Losasos/CP_PP_Tester/README.md

# CP_PP_Tester
Tester equipment for simulation of PWM communication (IEC61851-1) between electrical vehicle (EV) and a charging station (EVSE)
