Losasos/CP_PP_Tester/relay states.xlsx

# | Designator | Quantity | Part Number | Comment | Description | Manufacturer
1 | Rc5 | 1 |  | 51R
2 | Rc4 | 1 |  | 100R
3 | R13 | 1 |  | 120R
4 | R51 | 1 |  | 130R
5 | R52 | 1 |  | 140R
6 | R6 | 1 |  | 150R
7 | R50 | 1 |  | 178R
8 | R11, Rc3 | 2 |  | 220R
9 | R4, R7 | 2 |  | 330R
10 | R41 | 1 |  | 392R
11 | R40 | 1 |  | 422R
12 | R10, Rc2 | 2 |  | 680R
13 | R42 | 1 |  | 909R
14 | R31 | 1 |  | 920R | 910 +10
15 | R12 | 1 |  | 1000R
16 | Rc1 | 1 |  | 1500R
17 | R32 | 1 |  | 1820R | 1800 + 20
18 | R30 | 1 |  | 1870R
19 | R5 | 1 |  | 2700R
20 | R3 | 1 |  | 100k
21 | Rf1, Rf2 | 2 |  | 1M
22 | Cg | 1 |  | 1nF
23 | Cv | 1 |  | 1.4nF | 1,5nF
24 | Cc | 1 |  | 1.5nF
25 | Cf1, Cf2 | 2 |  | 47nF
26 | L1 | 1 |  | 1mH
27 | D1 | 1 | 1N4934 |  | Rectifier diode
28 | HF-Gen, Oszi | 2 |  |  | BNC connector
29 | SW_M | 1 |  |  | 2 state switch with 4 outputs, 1 or 2 inputs
30 | MOD1, MOD2 | 2 |  |  | Relays module, 8x relays, 5V DC control | ELEGOO
31 | MOD3 | 1 |  |  | Relays module, 4x relays, 5V DC control | ELEGOO
32 | MOD4 | 1 | Arduino Genuino MEGA 2560 |  | Arduino Uno R3 module, ATmega2560 + ATmega16U2 MCU | Sunfounder
33 | MOD5 | 1 |  |  | LCD display module, 16x2 characters, HD44780, with I2C driver | AZ Delivery
34 | MOD6 | 1 |  | 10k max | Digital potentiometer module, X9C103S IC, [P1] | ARCELI
35 | MOD7 | 1 |  |  | Keypad module 4x4 | AZ Delivery
36 | Ph, N, CP, Prox, PE, +V DC, h, RL-Ph, PL-N | 9 |  |  | Banana connector
37
38
39
40
41
42
43
44
45
46
47
48
49
