Losasos/CP_PP_Tester/TesterBox_top-Body.stl

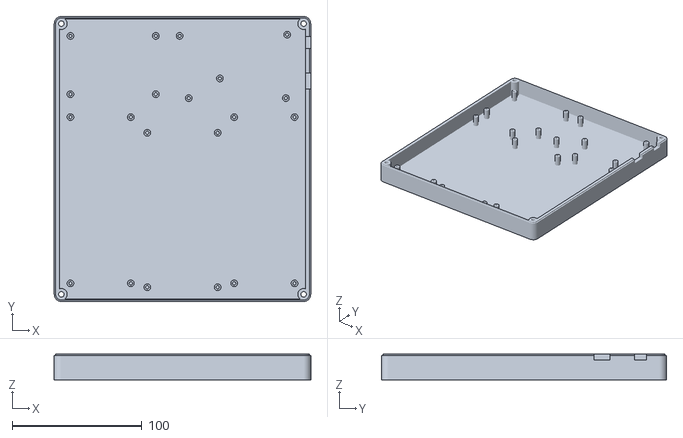
[picture p1: CAD file, 2026-03-22]
TesterBox_top-Body.stl
198.0 x 220.0 x 20.0
