Losasos/CP_PP_Tester/Tester_CP_PP.v2-cache.lib

## KiCad design Tester_CP_PP.v2-cache.lib (2026-03-22)

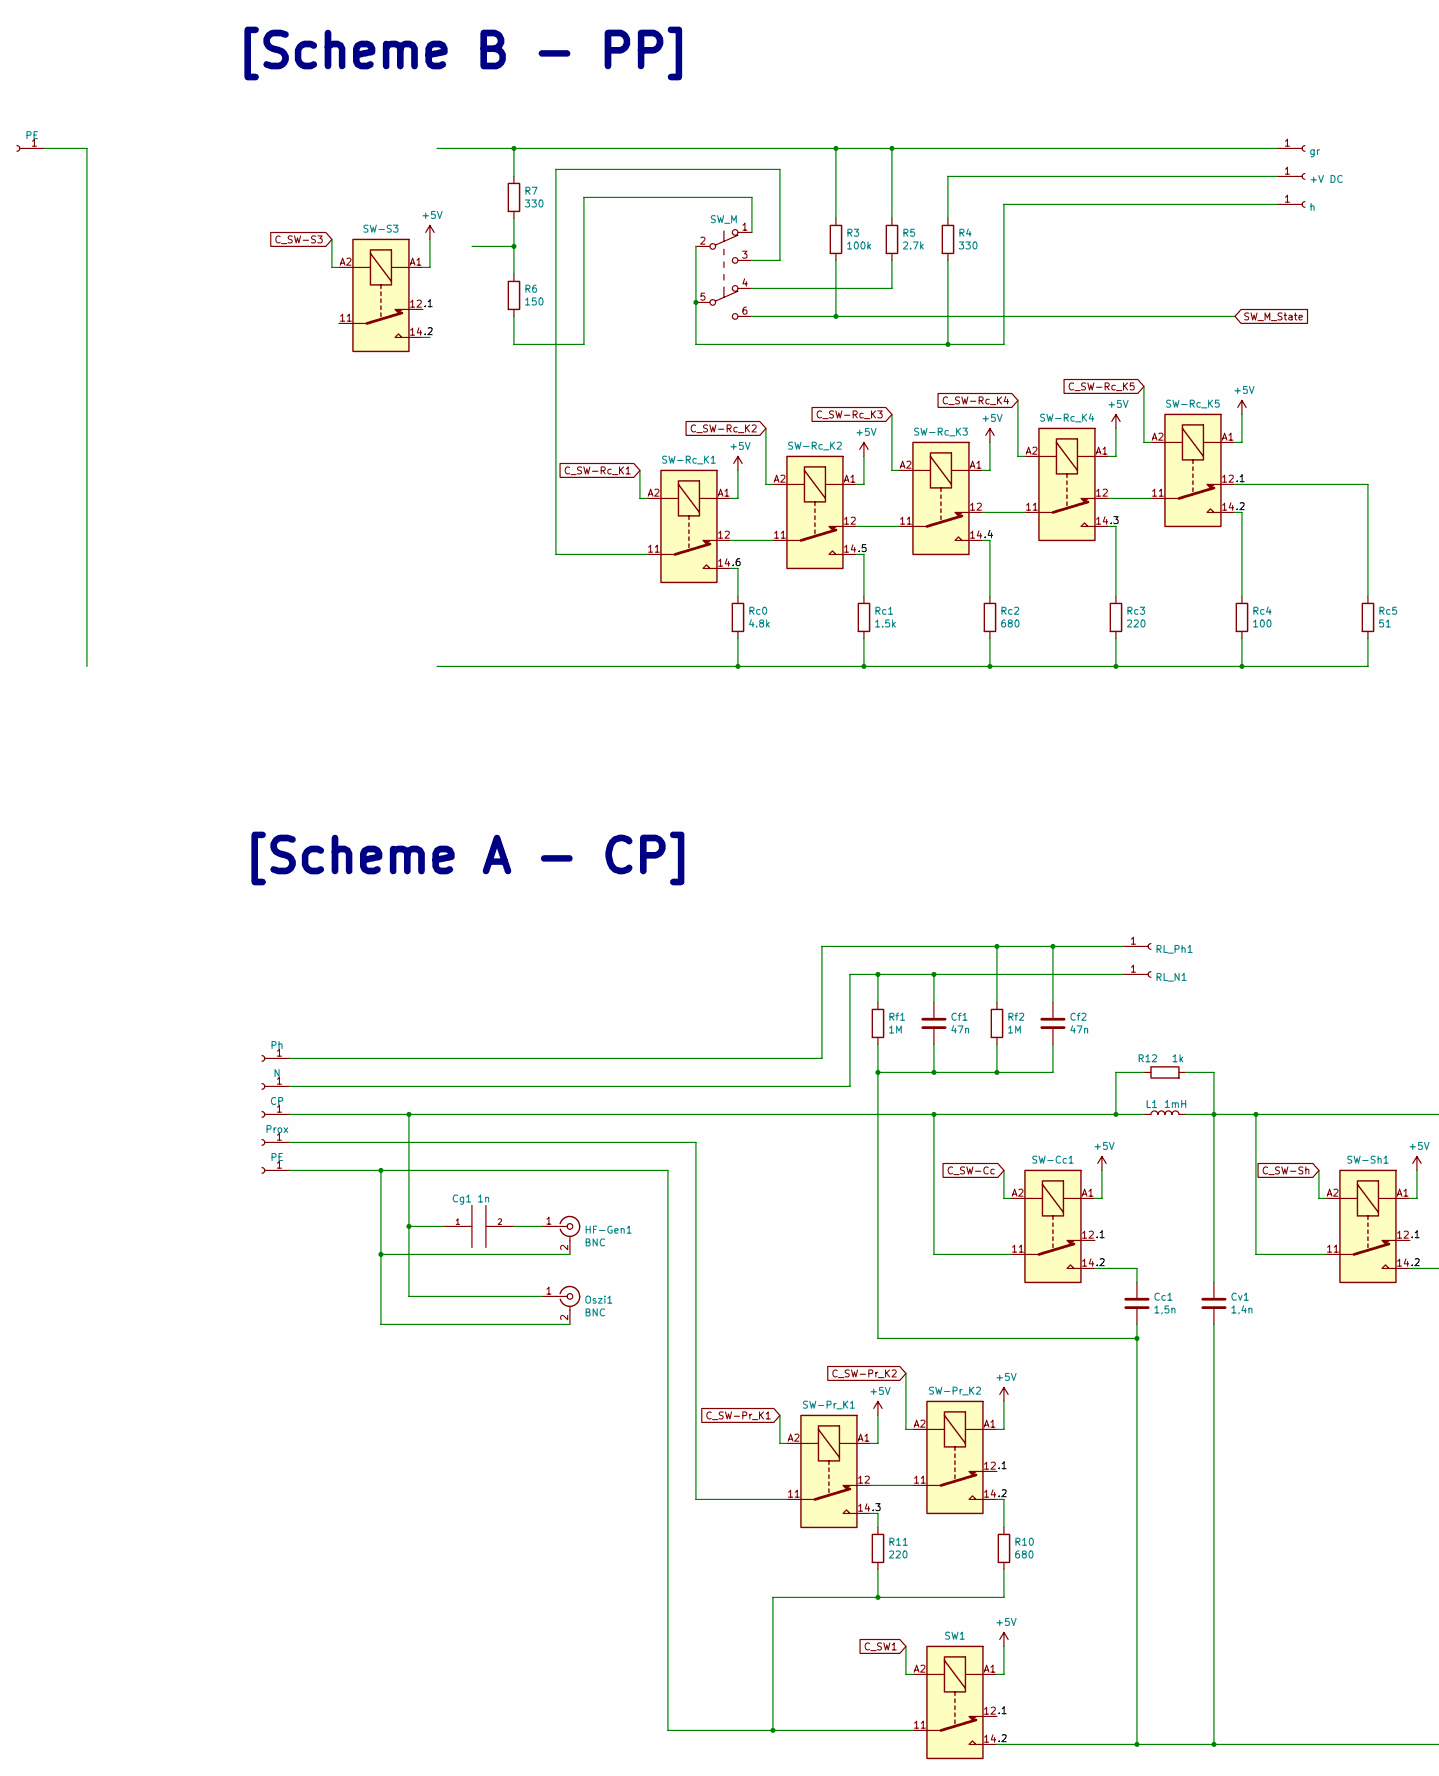
[picture p2: schematic Tester_CP_PP.v2-cache.lib, part in row 1, column 1]

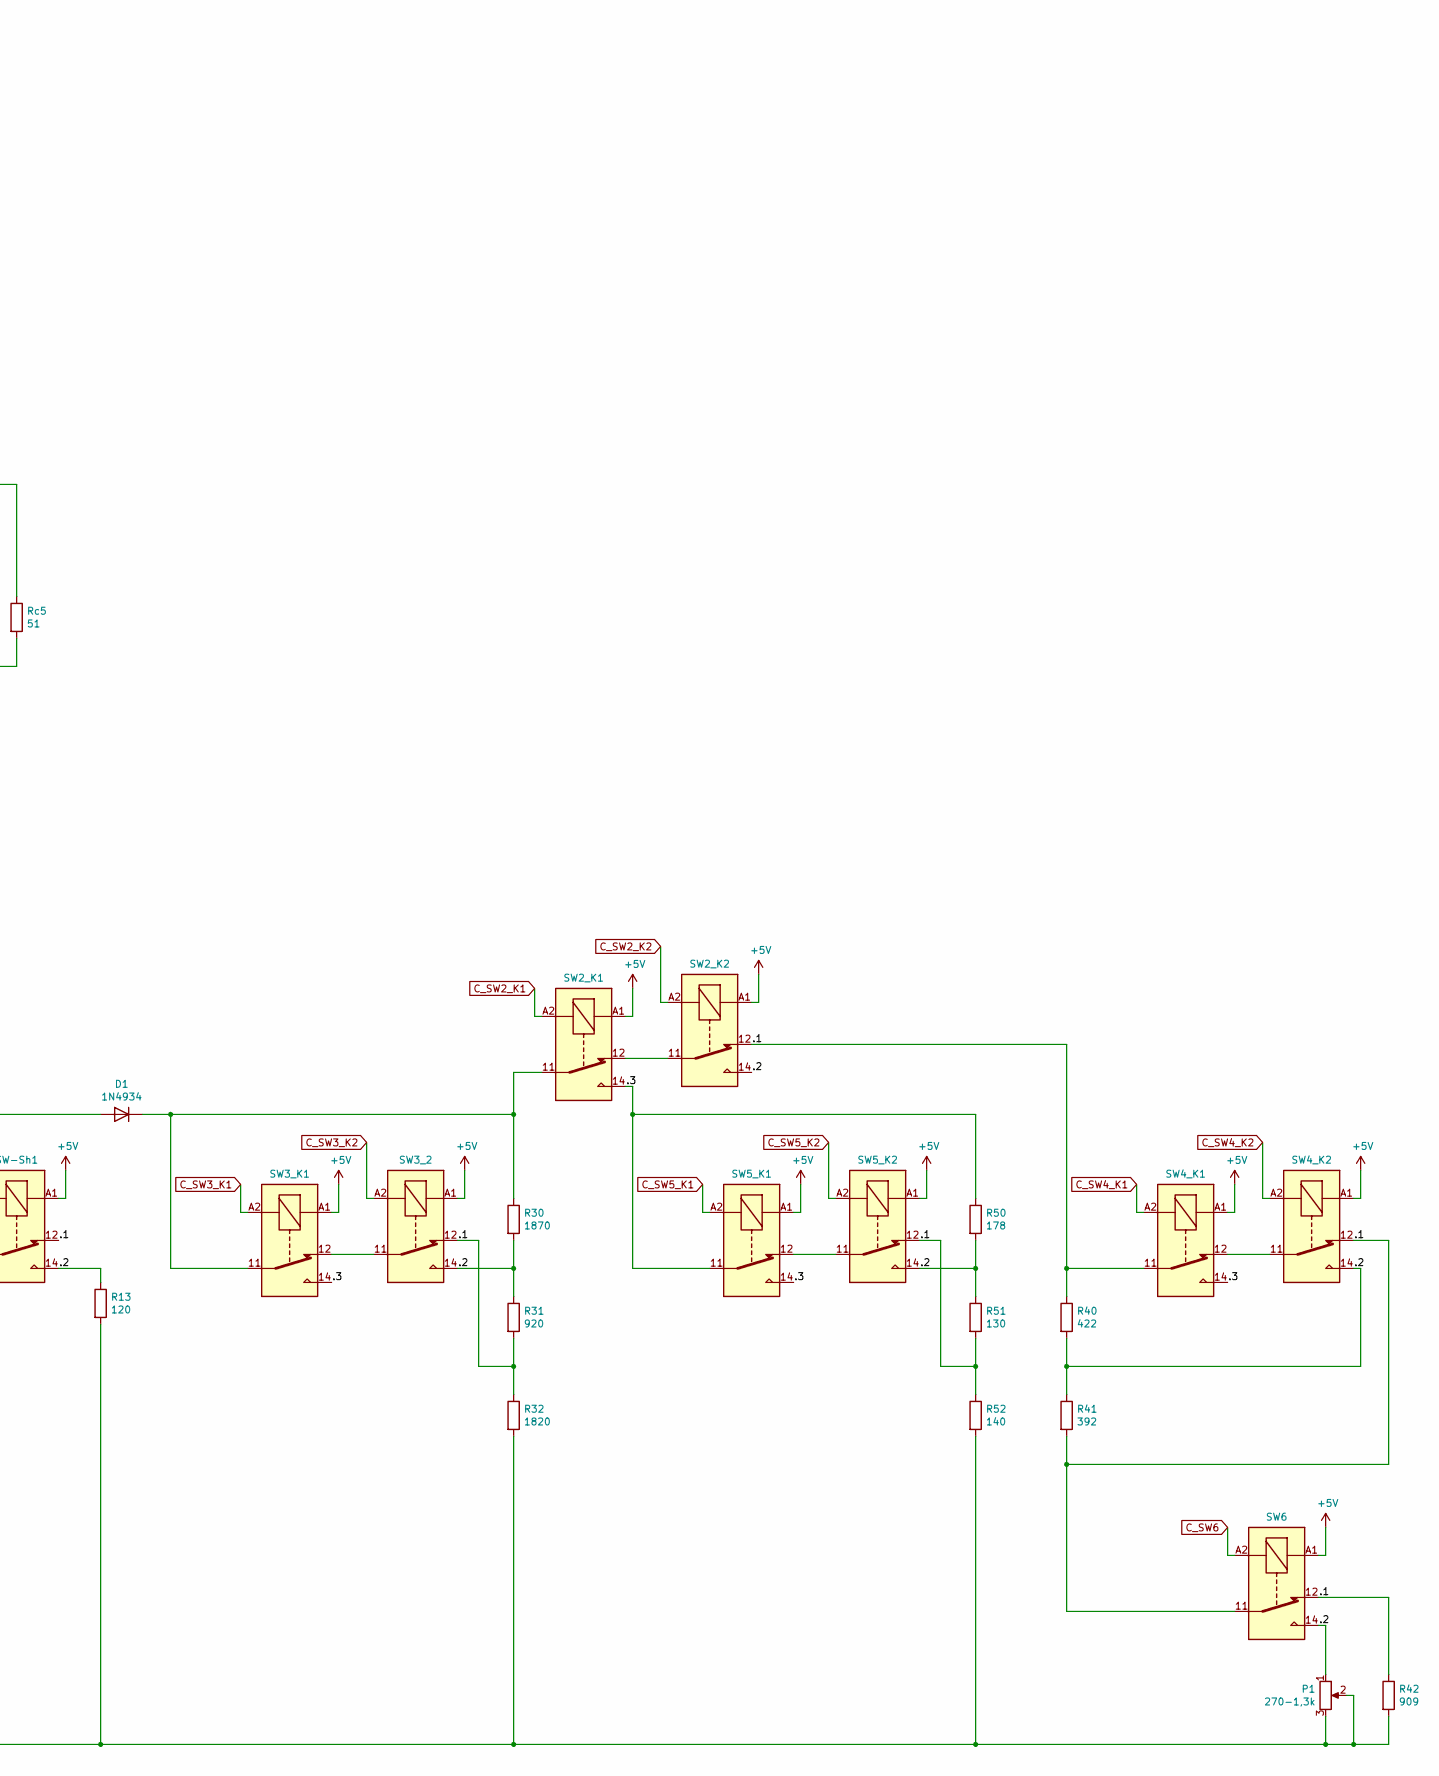
[picture p3: schematic Tester_CP_PP.v2-cache.lib, part in row 1, column 2]

Parts:
Banana1: PE
Banana2: gr
Banana3: +V DC
Banana4: h
Banana_socket1: Ph
Banana_socket2: N
Banana_socket3: CP
Banana_socket4: Prox
Banana_socket5: PE
Cc1: 1,5n
Cf1, Cf2: 47n
Cg1: 1n
Cv1: 1,4n
D1: 1N4934
HF-Gen1: BNC
L1: 1mH
Oszi1: BNC
P1: 270-1,3k
R3: 100k
R4, R7: 330
R5: 2.7k
R6: 150
R10: 680
R11: 220
R12: 1k
R13: 120
R30: 1870
R31: 920
R32: 1820
R40: 422
R41: 392
R42: 909
R50: 178
R51: 130
R52: 140
RL_N1: N
RL_Ph1: Ph
Rc0: 4.8k
Rc1: 1.5k
Rc2: 680
Rc3: 220
Rc4: 100
Rc5: 51
Rf1, Rf2: 1M
SW1, SW2_K1, SW2_K2, SW3_2, SW3_K1, SW4_K1, SW4_K2, SW5_K1, SW5_K2, SW6: .; Relay_SPDT_Finder_40.41
SW-Cc1: .; Relay_SPDT_Finder_40.41
SW-Pr_K1, SW-Pr_K2: .; Relay_SPDT_Finder_40.41
SW-Rc_K1, SW-Rc_K2, SW-Rc_K3, SW-Rc_K4, SW-Rc_K5: .; Relay_SPDT_Finder_40.41
SW-S3: .; Relay_SPDT_Finder_40.41
SW-Sh1: .; Relay_SPDT_Finder_40.41

Connections:
+5V: SW1.A1, SW2_K1.A1, SW2_K2.A1, SW3_2.A1, SW3_K1.A1, SW4_K1.A1, SW4_K2.A1, SW5_K1.A1, SW5_K2.A1, SW6.A1, SW-Cc1.A1, SW-Pr_K1.A1, SW-Pr_K2.A1, SW-Rc_K1.A1, SW-Rc_K2.A1, SW-Rc_K3.A1, SW-Rc_K4.A1, SW-Rc_K5.A1, SW-S3.A1, SW-Sh1.A1
.1: R31.2, R32.1, R40.1, R41.2, R42.1, R51.2, R52.1, Rc5.1, SW1.12, SW2_K2.12, SW3_2.12, SW4_K1.11, SW4_K2.12, SW5_K2.12, SW6.11, SW6.12, SW-Cc1.12, SW-Pr_K2.12, SW-Rc_K5.12, SW-S3.12, SW-Sh1.12
.2: Cc1.1, Cc1.2, Cf1.2, Cf2.2, Cv1.2, P1.1, P1.2, P1.3, R10.1, R13.1, R13.2, R30.2, R31.1, R32.2, R40.2, R41.1, R42.2, R50.2, R51.1, R52.2, Rc4.1, Rf1.2, Rf2.2, SW1.14, SW2_K2.14, SW3_2.14, SW4_K2.14, SW5_K2.14, SW6.14, SW-Cc1.14, SW-Pr_K2.14, SW-Rc_K5.14, SW-S3.14, SW-Sh1.14
.3: R11.1, R50.1, Rc3.1, SW2_K1.14, SW3_K1.14, SW4_K1.14, SW5_K1.11, SW5_K1.14, SW-Pr_K1.14, SW-Rc_K4.14
.4: Rc2.1, SW-Rc_K3.14
.5: Rc1.1, SW-Rc_K2.14
.6: Rc0.1, SW-Rc_K1.14
C_SW1: SW1.A2
C_SW2_K1: SW2_K1.A2
C_SW2_K2: SW2_K2.A2
C_SW3_K1: SW3_K1.A2
C_SW3_K2: SW3_2.A2
C_SW4_K1: SW4_K1.A2
C_SW4_K2: SW4_K2.A2
C_SW5_K1: SW5_K1.A2
C_SW5_K2: SW5_K2.A2
C_SW6: SW6.A2
C_SW-Cc: SW-Cc1.A2
C_SW-Pr_K1: SW-Pr_K1.A2
C_SW-Pr_K2: SW-Pr_K2.A2
C_SW-Rc_K1: SW-Rc_K1.A2
C_SW-Rc_K2: SW-Rc_K2.A2
C_SW-Rc_K3: SW-Rc_K3.A2
C_SW-Rc_K4: SW-Rc_K4.A2
C_SW-Rc_K5: SW-Rc_K5.A2
C_SW-S3: SW-S3.A2
C_SW-Sh: SW-Sh1.A2
unnamed: Banana2.1, R3.1, R5.1, R7.1
unnamed: Banana3.1, R4.1
unnamed: Banana4.1, R4.2
unnamed: Banana_socket1.1, Cf2.1, RL_Ph1.1, Rf2.1
unnamed: Banana_socket2.1, Cf1.1, RL_N1.1, Rf1.1
unnamed: Banana_socket3.1, Cg1.1, L1.1, Oszi1.1 (In), R12.1, SW-Cc1.11
unnamed: Banana_socket4.1, SW-Pr_K1.11
unnamed: Banana_socket5.1, HF-Gen1.2 (Ext), Oszi1.2 (Ext), R10.2, R11.2, SW1.11
unnamed: Cg1.2, HF-Gen1.1 (In)
unnamed: Cv1.1, D1.2 (A), L1.2, R12.2, SW-Sh1.11
unnamed: D1.1 (K), R30.1, SW2_K1.11, SW3_K1.11
unnamed: R6.1, R7.2
unnamed: Rc0.2, Rc1.2, Rc2.2, Rc3.2, Rc4.2, Rc5.2
unnamed: SW2_K1.12, SW2_K2.11
unnamed: SW3_2.11, SW3_K1.12
unnamed: SW4_K1.12, SW4_K2.11
unnamed: SW5_K1.12, SW5_K2.11
unnamed: SW-Pr_K1.12, SW-Pr_K2.11
unnamed: SW-Rc_K1.12, SW-Rc_K2.11
unnamed: SW-Rc_K2.12, SW-Rc_K3.11
unnamed: SW-Rc_K3.12, SW-Rc_K4.11
unnamed: SW-Rc_K4.12, SW-Rc_K5.11
SW_M_State: R3.2

Notes on the sheet:
[Scheme B - PP]
[Scheme A - CP]
