Losasos/CP_PP_Tester/User_Manual_for_EN61851-1_Tester_for_CP_&_PP_v3.0.docx

User Manual for EN61851-1 Tester for CP & PP v3.0

Powering

The box has two ways to be powered. To be plugged in by two banana cables +5V, -0V or to be connected with a power supply via barrel connector (outside ground) with voltage in range from 7 to 12 volts.

The red switch on the right side of the board is responsible for turning on and off the power for all relays, “B – case” switch and potentiometer servomotor.

As soon as the test box has power supply LCD display turns on and starts setup. During this time make sure it has the save version as this manual.

When device is ready the text will be changed and the display will suggest to choose a test case or to adjust the potentiometer if needed.

Case choosing functions

Test case can be chosen in various number of ways:

The keys “A” and “B” are used to choose between ‘A’ and ‘B’ tests. Start by pressing on of these. Afterwards the chosen test will be showed on display. At this point an opportunity to type case number by pressing on digit keys is available. To enter chosen case “#” key should be pressed. Pressing it second time will restart the case. When everything is ready an ”OK” will show up on the display. If the chosen case is not existed (for example case A17 or B0) display will say “wrong number”. This process can be repeated at any time by pressing “A” or “B” key, an exception is while decreasing or incising potentiometer in cases from 13 to 16.

Notice, that cases from 1 to 9 can be typed in two ways, with or without a Zero before the digit (for example A3 or A03) both variants are acceptable.

By pressing “*” key at any state, device will go to the start screen, an exception is while decreasing or incising potentiometer in cases from 13 to 16

There is another operativity to go to the next or to the previous cases. By pressing key “D” going forward and “C” going backwards. This function should allow to go through the all testing cases more easily.

Notice, the case ‘A’ is set as default, so if none of cases is shown, by pressing keys “C” or “D” the case A01 will be set up.

Special requirements for cases ‘A’ and ‘B’

In ‘A’ cases beginning from case number 3 an opportunity to change “Pr” switch state between 2 and 3 is available.

In ‘A’ cases beginning from case number 13 on opportunity to change resistance of potentiometer “P1” is available. By pressing key “1” the resistance potentiometer will start decrease slowly to stop this, the key “1” should be pressed once again. The same way works increasing of resistance by pressing key “2”. By pressing key “4” resistance of potentiometer will be decreased by 1 degree of servomotor, in opposite by pressing key “5” resistance of potentiometer will be increased by 1 degree of servomotor. These one-degree steps should be used to finde out where the switching device opens or closes more precisely.

In ‘B’ cases the right positioning of the small metal toggle switch on top of the Box is needed. Up pointing position for cases B1 and B2, and down pointing position for cases from B3 to B8. If the switch is in the wrong position the message “switch is wrong” will be shown on the display.

Potentiometer adjustment function

Being on the start screen a function to adjust potentiometer “P1” is available. It is shown by message “0 to adjust Pot” at the bottom of the display. Pressing the “0” key will enter potentiometer settings menu. By pressing “D” key the settings option will be changed to the next, to accept setting option the “#” should be pressed. The chosen variant will be shown at the top of the screen. On the bottom of the screen two numbers will be shown.

Both numbers represent the angle of potentiometer in degrees measurement units with minimum of 0° and maximum of 180°. The first is the saved position which was set before. The second is the current position. At this point it is possible to go to the start screen by pressing key “*” or to go one step back to the choosing menu by pressing “0” key.

To change the current angle keys “1” and ”2” can be pressed to change the angle by one degree, or keys “4” and “5” to change the angle by ten degrees at one time.

A new position can be saved by pressing “#” key. Afterwards the device will ask if the user is surely wanting to change the saved position. At this point pressing key “#” once again will be counted as a positive (acceptation to save new angle) and key “*” as a negative (declination to save new angle) answer.

! ATTENTION ! The saved angle must only be changed, if potentiometer is connected to an ohmmeter.
